taavi/vocal_keys/SchematicMatrix8x8.png

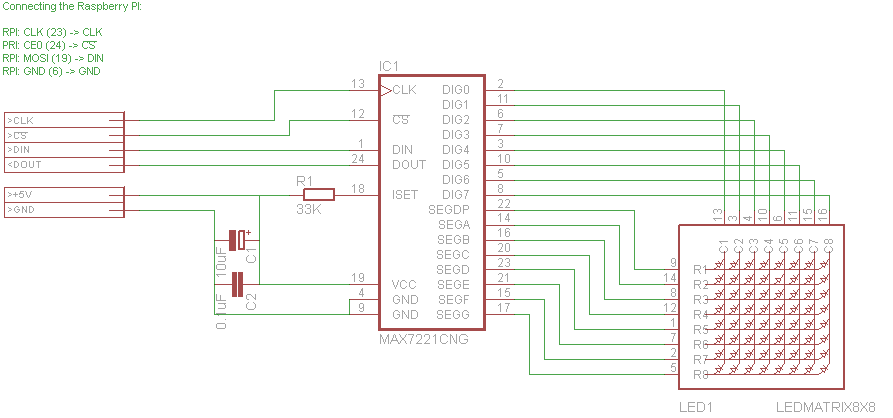
SchematicMatrix8x8.png
