taavi/vocal_keys/VocalKeysVisualDriver.png

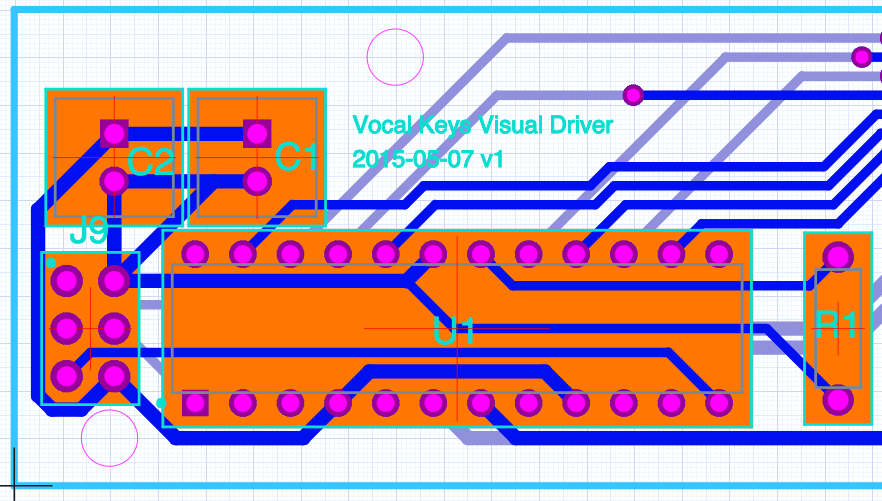
VocalKeysVisualDriver.png
