taavi/vocal_keys/(commit log)

2015-05-10 New code for generating tones; easier to adjust sample rate, and interpolates halfway between samples half the time.
2015-05-13 First bit of midi glue
2015-05-14 First crack at the actual glue.
    [glue.py]
2015-05-14 glue should now configure the max7221 properly
2015-05-25 Fixes bit ordering for lighting
    [glue.py]
2015-05-25 Filters the midi through found on raspi
2015-05-25 Adds spi max7221 example
2015-05-25 Adds ioctl config for spi
2015-05-26 The half-samples were causing a LOT of noise. Disabling.
    [tone_generator.ino]
2015-05-27 Adds rendered wiring
